celalberq/fpga-orin-renewable-energy-systems/system-integration/reports/assets/demo_final_full.png

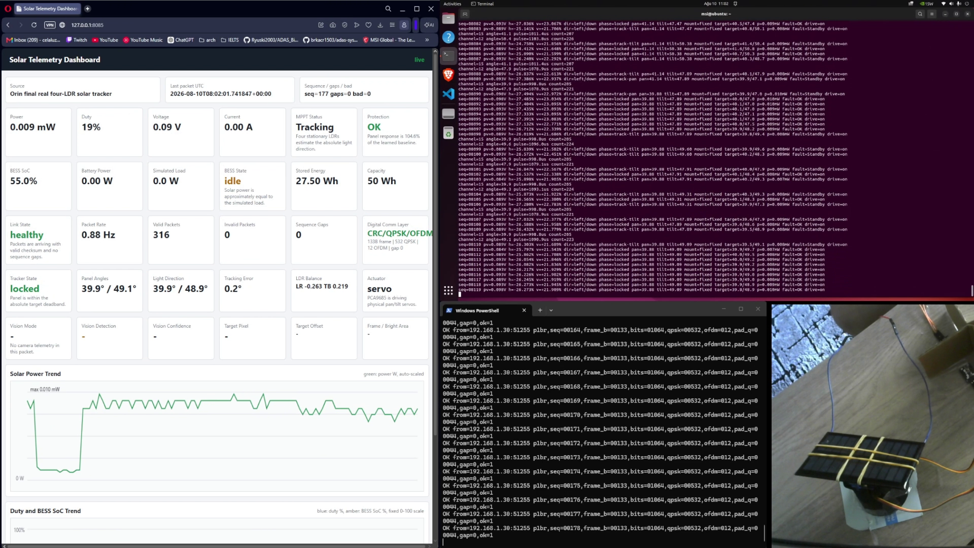
system-integration/reports/assets/demo_final_full.png
