celalberq/fpga-orin-renewable-energy-systems/network-telemetry-dashboard/hardware/README.txt

Network Telemetry Dashboard Hardware Scope
=====================

The validated network layer is PC software over the existing Ethernet/Wi-Fi
LAN. No dedicated inline Ethernet FPGA appliance is claimed.

```text
constraints/  Baseline Nexys Video LED constraint only
pin_maps/     Notes for optional future Ethernet-HDL work
```
