celalberq/fpga-orin-renewable-energy-systems/fpga-digital-communications/data/README.txt

FPGA Digital Communications Communication Evidence Data
==================================

This folder contains simulation outputs, constellation/reference datasets,
live bridge logs, and CRC/QPSK/OFDM profile evidence.

Current generated tracker-link datasets:

```text
tracker_packet_comm_sim.csv
tracker_packet_examples.csv
tracker_qpsk_packet_link_sim.csv
tracker_qpsk_packet_link_constellation.csv
tracker_ofdm_packet_link_sim.csv
tracker_ofdm_resource_grid_example.csv
```

Primary final dataset:

```text
unified_tracker_bess_bidirectional_demo_bridge.csv
  368/368 CRC-valid 161-byte frames, 0 sequence gaps
```
