celalberq/fpga-orin-renewable-energy-systems/network-telemetry-dashboard/data/README.txt

Network Telemetry Dashboard Network and Dashboard Evidence Data
==========================================

This folder contains UDP receiver logs, dashboard logs, reliability-injection
evidence, link-health summaries, and real BESS charge/discharge captures.

Primary final dataset:

```text
unified_tracker_bess_bidirectional_demo_dashboard.csv
  368 valid packets, 0 invalid packets, 0 gaps
  states: idle, charging, discharging
```
