celalberq/fpga-orin-renewable-energy-systems/solar-tracker-bess/data/README.txt

Solar Tracker and BESS Renewable-Control Evidence Data
======================================

This folder contains solar/PWM reference data, LDR calibration and directional
sweeps, fixed-versus-tracking A/B measurements, and transferred Orin tracker
logs.

The final Orin CSV is generated as
`solar-tracker-bess/data/unified_tracker_bess_bidirectional_demo.csv` on the Orin. Matching
PC-side bridge and dashboard records are indexed in `system-integration/demo_evidence`.
