celalberq/fpga-orin-renewable-energy-systems/solar-tracker-bess/docs/README.txt

Solar Tracker and BESS Hardware and Integration Records
=======================================

The numbered records preserve the progression from PWM/UART bring-up through
real MCP3208 sensing, physical two-axis tracking, shading recovery, real BESS
charge/discharge measurement, and the final continuous integrated demo.

Current docs:

```text
board_test_01_pwm_uart.txt
board_test_02_scaled_telemetry.txt
board_test_03_shared_packet_v1.txt
board_test_04_auto_mppt_uart_dashboard.txt
board_test_05_real_sensing_mcp3208.txt
board_test_06_real_solar_voltage_mcp3208.txt
board_test_07_ina226_orin_i2c.txt
board_test_08_orin_ina226_udp_dashboard.txt
board_test_09_pca9685_servo_orin_i2c.txt
board_test_10_pan_tilt_servo_orin_i2c.txt
board_test_11_software_tracker_udp.txt
board_test_12_servo_tracker_udp.txt
board_test_13_mounted_panel_integrated_demo.txt
board_test_14_camera_light_tracker_udp.txt
board_test_15_pan_only_camera_tracker.txt
board_test_16_fixed_vs_pan_tracking_power.txt
board_test_17_ky018_mcp3208_ldr_uart.txt
board_test_18_replacement_pan_tilt_mechanism.txt
board_test_19_ldr_servo_tracker_orin.txt
board_test_20_ldr_tracker_udp_dashboard.txt
board_test_21_ldr_shading_fault_detection.txt
board_test_22_real_bess_ina226_discharge.txt
board_test_23_real_bess_charge_udp_dashboard.txt
board_test_24_unified_tracker_bess_discharge.txt
board_test_25_unified_tracker_bess_bidirectional_demo.txt
servo_mechanics_repair_research_2026_08_07.txt
real_sensing_stage_01_plan.txt
pc_parser_logger_v1.txt
telemetry_format_v1.txt
mppt_fault_logic_v1.txt
```
