celalberq/fpga-orin-renewable-energy-systems/network-telemetry-dashboard/hardware/pin_maps/README.txt

Pin Maps Folder
===============

No dedicated hardware pin map is used by the validated Network Telemetry Dashboard result because
transport and dashboard services run on the PC LAN interfaces. This folder is
reserved for an optional future inline FPGA Ethernet extension.
