celalberq/fpga-orin-renewable-energy-systems/solar-tracker-bess/hardware/pin_maps/README.txt

Pin Maps Folder
===============

Authoritative FPGA assignments are in `../constraints`. The single current
source of truth for bench wiring, connector allocation, power separation, BESS
mode switching, and the BOM is:

```text
system-integration/final_hardware_wiring_2026_08_11.md
```

Dated bring-up details and raw observations remain in `solar-tracker-bess/docs`, especially
board tests 17-25.
