celalberq/fpga-orin-renewable-energy-systems/fpga-digital-communications/hardware/constraints/README.txt

Constraints Folder
==================

Nexys Video XDC files for the validated communication progression are stored
here, from CRC/UART loopback through QPSK and OFDM accounting to the final
tracker-frame batch top.

Primary final board build:

```text
nexys_video_tracker_frame_qpsk_ofdm_batch.xdc
```
