celalberq/fpga-orin-renewable-energy-systems/network-telemetry-dashboard/hardware/constraints/README.txt

Constraints Folder
==================

Current content is the baseline `nexys_video_led_switch.xdc`. Dedicated
Ethernet/UART FPGA constraints are optional future work and are not part of the
validated PC-side UDP dashboard result.
