celalberq/fpga-orin-renewable-energy-systems/solar-tracker-bess/hardware/constraints/README.txt

Constraints Folder
==================

Nexys Video XDC files for PWM/UART, shared packets, MPPT demonstration, real
MCP3208 sensing, and the four-LDR UART build are stored here.

Primary final sensor build:

```text
nexys_video_solar_ldr_uart.xdc
```

The earlier MPPT/PWM constraints remain as validated development-stage assets.
