celalberq/fpga-orin-renewable-energy-systems/solar-tracker-bess/code/sim/README.txt

Simulation Folder
=================

Implemented simulation:

```text
pwm_reference_model.py
```

Additional MPPT, sensing, and protection behavior is validated through the HDL
board tests and live Orin/dashboard records rather than separate files here.
