celalberq/fpga-orin-renewable-energy-systems/fpga-digital-communications/L1_design.txt

L1 Design: Digital Communication Project
========================================

Document status
---------------

```text
ORIGINAL DESIGN TARGET / PLANNING BASELINE

This file preserves the initial project ambition. It is not an as-built
specification and must not be read as a claim that every item below was
implemented. Current delivered scope is documented in `fpga-digital-communications/README.md` and
`system-integration/current_system_status_2026_08_11.txt`.
```

Delivered baseline - 2026-08-11
-------------------------------

```text
Implemented:
  CRC-protected renewable telemetry framing.
  QPSK mapping and AWGN packet-link simulation.
  Software IFFT/FFT OFDM packet-link simulation.
  Nexys Video proofs for CRC, QPSK category mapping, OFDM resource placement,
  pilot/null/padding accounting, and cyclic-prefix sequencing.
  Live PC bridge for compact tracker/panel/BESS frames and QPSK/OFDM sizing.
  Final continuous run: 368/368 software bridge frames valid, zero gaps.

Not implemented:
  Live unified payload passing through the FPGA communication pipeline.
  FPGA IFFT/FFT baseband modem, DAC/ADC or RF link, adaptive modulation,
  hardware receiver BER/EVM measurement, or Orin AI link adaptation.
```

Project title:

FPGA-Accelerated Adaptive OFDM Communication Link with Orin-Based Link Monitoring

Original main goal:

Design and demonstrate a digital communication reliability layer for the shared renewable telemetry packet, where the FPGA handles real-time framing/baseband work and the Orin Nano Super handles experiment control, visualization, logging, and optional AI-based adaptation.

Original target architecture:

```text
Shared solar-tracker-bess renewable telemetry packet
  -> frame builder
  -> CRC/checksum
  -> FPGA transmitter
  -> digital modulation later
  -> OFDM framing
  -> DAC / PWM-DAC / simulated channel / optional RF front-end
  -> ADC / digital loopback
  -> FPGA receiver
  -> link metrics
  -> Orin Nano dashboard and logging
```

Original planned FPGA role:

```text
1. Bit generation or packet input.
2. QPSK and 16-QAM mapping.
3. OFDM frame creation.
4. IFFT/FFT or staged FFT core.
5. Cyclic prefix insertion and removal.
6. Pilot insertion and channel estimation.
7. BER, packet error, and EVM-style metric calculation.
8. Telemetry streaming to Orin.
```

Original planned Orin Nano role:

```text
1. Dashboard for BER, SNR estimate, packet rate, and constellation plots.
2. Experiment control.
3. CSV/JSON logging.
4. Optional AI model that predicts the best modulation mode.
5. Report plots and demo visuals.
```

Original MVP scope:

```text
1. Start with digital loopback inside FPGA.
2. Add noise/channel model in FPGA or Orin simulation.
3. Add ADC/DAC loopback if hardware is available.
4. Add RF front-end only after baseband works.
```

Original success metrics:

```text
1. QPSK link runs end to end.
2. Receiver recovers packets and calculates BER.
3. Orin dashboard displays live metrics.
4. At least two channel conditions are tested.
5. Final demo compares fixed modulation and adaptive modulation.
```

CV value:

This project demonstrates communication theory, reliable telemetry transfer, real-time FPGA signal processing, embedded AI monitoring, and hardware/software co-design.
