celalberq/fpga-orin-renewable-energy-systems/system-integration/demo_evidence/final_system_architecture_2026_08_11.md

# Final Integrated System Architecture

```mermaid
flowchart LR
    LDR["4x KY-018 light sensors"] --> ADC["MCP3208 ADC"]
    PV["Solar panel + 1k load divider"] --> ADC
    ADC --> FPGA["Nexys Video FPGA\nSPI sampling + UART stream"]
    FPGA --> ORIN["Jetson Orin Nano\nLDR tracking + telemetry gateway"]

    ORIN --> PCA["PCA9685"]
    PCA --> PAN["Pan servo CH15"]
    PCA --> TILT["Tilt servo CH12"]
    PAN --> MOUNT["Moving panel mount"]
    TILT --> MOUNT

    CELL["Protected 1S Li-ion cell"] --> INA["INA226 signed BESS sensing"]
    INA --> ORIN
    CELL --> TP["TP4056 charger/protection"]
    TP --> FAN["L9110 fan discharge load"]

    ORIN --> UDP["Unified tracker + panel + BESS UDP packet"]
    UDP --> COMM["FPGA Digital Communications CRC/QPSK/OFDM bridge"]
    COMM --> DASH["Network Telemetry Dashboard live dashboard + CSV logger"]
```

## Ownership

```text
Solar Tracker and BESS: sensing, tracking, servo actuation, panel/BESS telemetry, protection state
FPGA Digital Communications: CRC framing, QPSK/OFDM profile, FPGA communication pipeline proof
Network Telemetry Dashboard: UDP transport, validation, sequence-gap monitoring, dashboard, CSV logs
```

## Final Unified Packet Profile

```text
Payload: 157 bytes
CRC frame: 161 bytes / 1288 bits
QPSK: 644 symbols
OFDM: 14 symbols
QPSK padding: 28 symbols
```

## Continuous Final Demonstration

```text
Dashboard packets: 368/368 valid, 0 invalid, 0 sequence gaps
Bridge frames: 368/368 CRC-valid, 0 sequence gaps
BESS sequence: idle -> charging -> idle -> discharging -> idle
Tracker: 213 locked samples, 0.012-degree best observed error
```

The TP4056 USB input and fan load were used in separate supervised phases; they
were never active simultaneously. The Orin and Nexys Video remained on their
normal external supplies. The initial approximately 0.63 V INA226 bus value was
an open-path reading and is not used as battery-voltage evidence.
