celalberq/fpga-orin-renewable-energy-systems/system-integration/demo_evidence/demo_run_checklist.txt

Demo Run Checklist
==================

Goal
----

Record one clean 60-90 second demo showing the real four-LDR tracker, physical
two-axis panel movement, shading detection, digital communication bridge, and
network dashboard working together.

Before Starting
---------------

```text
1. Orin is powered on.
2. PC and Orin are on the same network.
3. Orin IP is known. Current known Orin IP: 192.168.1.30.
4. PC IP is known. Current known PC IP: 192.168.1.219.
5. Nexys Video board code uses Vivado part: xc7a200tsbg484-1.
6. Nexys Video is powered and visible on Orin as /dev/ttyUSB0.
7. If dashboard is already running, close the old terminal first.
```

Send To Orin
------------

```text
Skip, already installed.
```

PC Terminal 1: Dashboard
------------------------

```powershell
cd "<repository-root>"
python network-telemetry-dashboard/code/pc_app/solar_live_dashboard.py `
  --udp-host 0.0.0.0 --udp-port 5011 `
  --http-host 127.0.0.1 --http-port 8085 `
  --bess-load-w 0 `
  --log network-telemetry-dashboard/data/solar_live_dashboard_final_demo.csv
```

Open:

```text
http://127.0.0.1:8085
```

Expected:

```text
Top right says live.
Source says Orin final real four-LDR solar tracker after packets arrive.
Link State becomes healthy.
Digital Comm Layer becomes CRC/QPSK/OFDM.
Sequence gaps stays 0 during a clean run.
Invalid packets stays 0 during a clean run.
Protection moves through Standby, Learning, OK, Shading, and back to OK.
```

PC Terminal 2: FPGA Digital Communications Bridge
----------------------------

```powershell
cd "<repository-root>"
python fpga-digital-communications/code/pc_app/tracker_udp_comm_bridge.py `
  --bind-host 0.0.0.0 --bind-port 5013 `
  --forward-host 127.0.0.1 --forward-port 5011 `
  --max-packets 180 `
  --log fpga-digital-communications/data/ldr_tracker_bridge_final_demo.csv
```

Expected terminal lines:

```text
OK from=192.168.1.30:xxxxx p1br,seq=00000,frame_b=00133,bits=01064,qpsk=00532,ofdm=012,pad_q=00044,gap=0,ok=1
```

Orin Window: Real LDR Tracker
-----------------------------

```bash
cd /home/msi
python3 solar-tracker-bess/code/orin_app/ldr_servo_tracker.py \
  --port /dev/ttyUSB0 \
  --calibration-in solar-tracker-bess/data/ldr_ab_calibration.json \
  --sensor-mount fixed --control-mode sequential \
  --max-packets 180 --drive-servos \
  --bus 7 --addr 0x40 --pan-channel 15 --tilt-channel 12 \
  --pan-start 90 --tilt-start 90 \
  --pan-min 10 --pan-max 170 --tilt-min 10 --tilt-max 170 \
  --fixed-tilt-gain 120 --fixed-center-deadband 0.015 \
  --fixed-hemisphere-deadband 0.05 --target-deadband-deg 1.0 \
  --min-step 0.5 --max-step 3.0 --stable-samples 2 --invert-tilt \
  --panel-load-ohms 1000 \
  --shading-learn-samples 8 --shading-drop-ratio 0.5 \
  --shading-trigger-samples 3 --shading-recovery-samples 3 \
  --udp-host 192.168.1.219 --udp-port 5013 \
  --source-label "Orin final real four-LDR solar tracker" \
  --log solar-tracker-bess/data/ldr_tracker_final_demo.csv --overwrite-log
```

Expected terminal lines:

```text
seq=... pv=... h=... v=... phase=... pan=... tilt=... fault=... drive=on
```

Expected dashboard changes:

```text
Panel Angles move from 90/90 toward the real LDR target.
Tracker State reaches locked.
Protection learns a baseline, detects panel-only shading, and recovers.
Digital Comm Layer stays CRC/QPSK/OFDM.
Link State stays healthy.
```

Nexys Video Evidence Clip
-------------------------

Use this when recording the FPGA part:

```text
Vivado part:
  xc7a200tsbg484-1

Board test:
  fpga-digital-communications/code/hdl/tracker_frame_qpsk_ofdm_batch_top.v

Constraints:
  fpga-digital-communications/hardware/constraints/nexys_video_tracker_frame_qpsk_ofdm_batch.xdc

Expected UART:
  p1bat,seq=00013,sym=00532,...,data=00532,pad=00044,pilot=00048,null=00144,cp=00192,crc=81,ok=1
```

What To Capture
---------------

```text
1. 10 seconds: physical panel moving from 90/90 toward the light target.
2. 5 seconds: Orin terminal showing real LDR values and drive=on.
3. 5 seconds: PC bridge showing p1br ok=1.
4. 10 seconds: dashboard live/healthy with gaps 0, bad 0, CRC/QPSK/OFDM.
5. After Protection reaches OK, cover only the panel face until Shading appears.
6. Uncover the panel and capture Protection returning to OK.
7. End on the full hardware setup and healthy dashboard.
```

Demo Talking Points
-------------------

```text
This is one system split into three engineering layers.

solar-tracker-bess is the renewable-energy layer:
  tracker state, solar sensing, INA226, Orin edge gateway.

fpga-digital-communications is the communication reliability layer:
  CRC frame, QPSK symbol mapping, OFDM packet sizing, FPGA validation.

network-telemetry-dashboard is the network monitoring layer:
  UDP transport, packet validation, gap detection, live dashboard.
```

If Something Fails
------------------

```text
Dashboard does not update:
  Check that bridge is forwarding to port 5011.
  Check browser is on http://127.0.0.1:8085.

Bridge does not print:
  Check Orin gateway is sending to PC IP and port 5013.
  Check PC firewall if needed.

INA226 reads zero:
  This can be normal indoors with weak light.
  Use a stronger light or sunlight for power plots.

Digital Comm Layer says raw UDP:
  Orin is probably sending directly to dashboard instead of through the bridge.
  Correct path is Orin -> port 5013 bridge -> port 5011 dashboard.
```

Reliability Warning/Recovery Demo
---------------------------------

Use this after the clean demo is working. This keeps the full integrated path,
but inserts the proxy after the fpga-digital-communications bridge.

Fast PC-side startup:

```powershell
cd "<repository-root>"
powershell -ExecutionPolicy Bypass -File system-integration/demo_evidence/start_reliability_demo_pc.ps1
```

Stop PC-side demo:

```powershell
cd "<repository-root>"
powershell -ExecutionPolicy Bypass -File system-integration/demo_evidence/stop_reliability_demo_pc.ps1
```

Dashboard:

```powershell
cd "<repository-root>"
python network-telemetry-dashboard/code/pc_app/solar_live_dashboard.py --udp-host 0.0.0.0 --udp-port 5011 --http-host 127.0.0.1 --http-port 8085 --bess-load-w 0.1 --recovery-window 10 --log network-telemetry-dashboard/data/solar_live_dashboard_reliability_bridge_log.csv
```

Reliability proxy:

```powershell
cd "<repository-root>"
python network-telemetry-dashboard/code/pc_app/solar_reliability_proxy.py --bind-host 0.0.0.0 --bind-port 5012 --forward-host 127.0.0.1 --forward-port 5011 --drop-every 7 --corrupt-every 9 --inject-first 30 --log network-telemetry-dashboard/data/solar_reliability_proxy_bridge_log.csv
```

FPGA Digital Communications bridge:

```powershell
cd "<repository-root>"
python fpga-digital-communications/code/pc_app/tracker_udp_comm_bridge.py --bind-host 0.0.0.0 --bind-port 5013 --forward-host 127.0.0.1 --forward-port 5012 --log fpga-digital-communications/data/tracker_udp_comm_bridge_reliability_log.csv
```

Orin tracker:

```bash
cd /home/msi
python3 solar-tracker-bess/code/orin_app/tracker_softloop_udp_gateway.py --udp-host 192.168.1.219 --udp-port 5013 --lock-error-deg 10 --ina-enable --ina-bus 7 --ina-addr 0x44 --shunt-ohms 0.1
```

Expected sequence:

```text
1. Dashboard starts healthy.
2. Proxy injects drop/corruption during first 30 packets.
3. Dashboard Link State becomes warning.
4. Proxy automatically returns to clean forwarding.
5. Dashboard Link State becomes recovered after 10 clean recent packets.
```
