celalberq/fpga-orin-renewable-energy-systems/network-telemetry-dashboard/docs/README.txt

Network Telemetry Dashboard Network Verification Records
===================================

These records cover UDP transport, dashboard operation, BESS enrichment, link
health, injected reliability faults, bridge status, and recovery behavior.

Current docs:

```text
network_test_01_solar_udp_gateway.txt
network_test_02_live_dashboard.txt
network_test_03_bess_soc_dashboard.txt
network_test_04_link_health_dashboard.txt
network_test_05_orin_ina226_udp_sensor.txt
network_test_06_software_tracker_udp_dashboard.txt
network_test_07_tracker_reliability_proxy.txt
network_test_08_tracker_bridge_dashboard_status.txt
network_test_09_tracker_bridge_reliability_warning_recovery.txt
network_test_10_camera_tracker_dashboard.txt
```

The final dashboard evidence is stored in
`data/unified_tracker_bess_bidirectional_demo_dashboard.csv`: 368/368 valid
packets, zero invalid packets, and zero sequence gaps.
