celalberq/fpga-orin-renewable-energy-systems/system-integration/demo_evidence/final_presentation/_rendered/slide-02.png

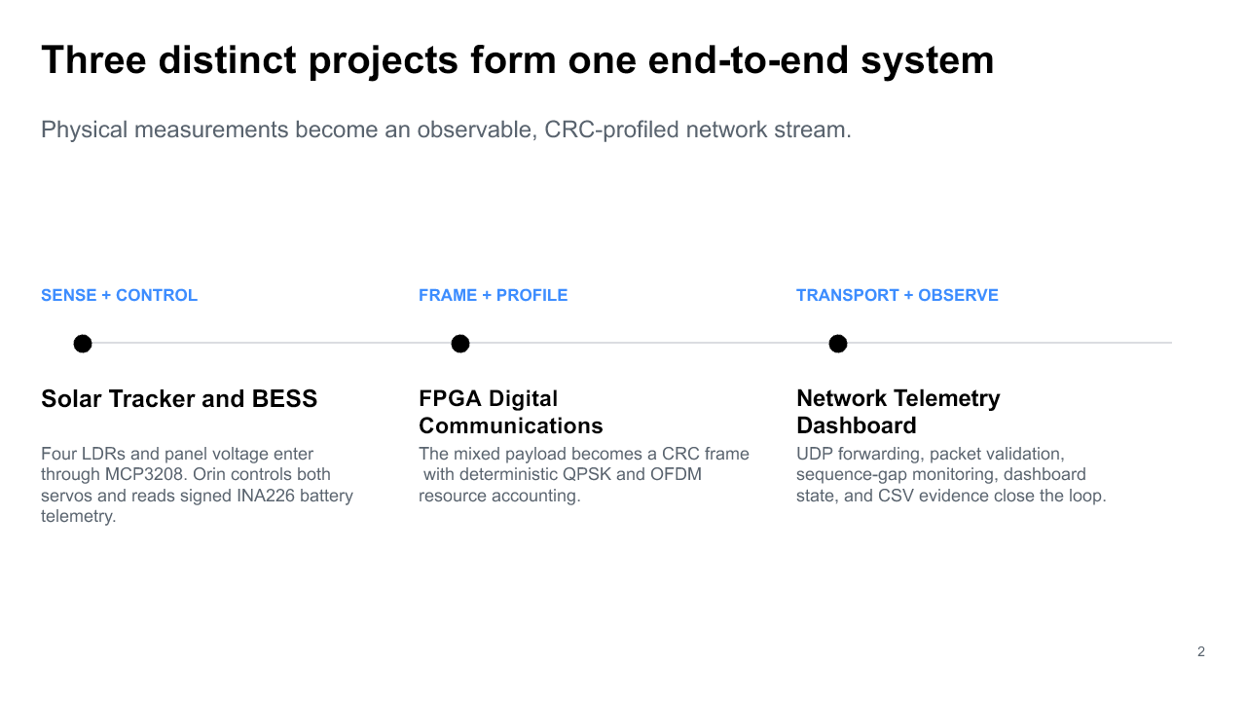
system-integration/demo_evidence/final_presentation/_rendered/slide-02.png
