celalberq/fpga-orin-renewable-energy-systems/system-integration/demo_evidence/final_presentation/_rendered/slide-03.png

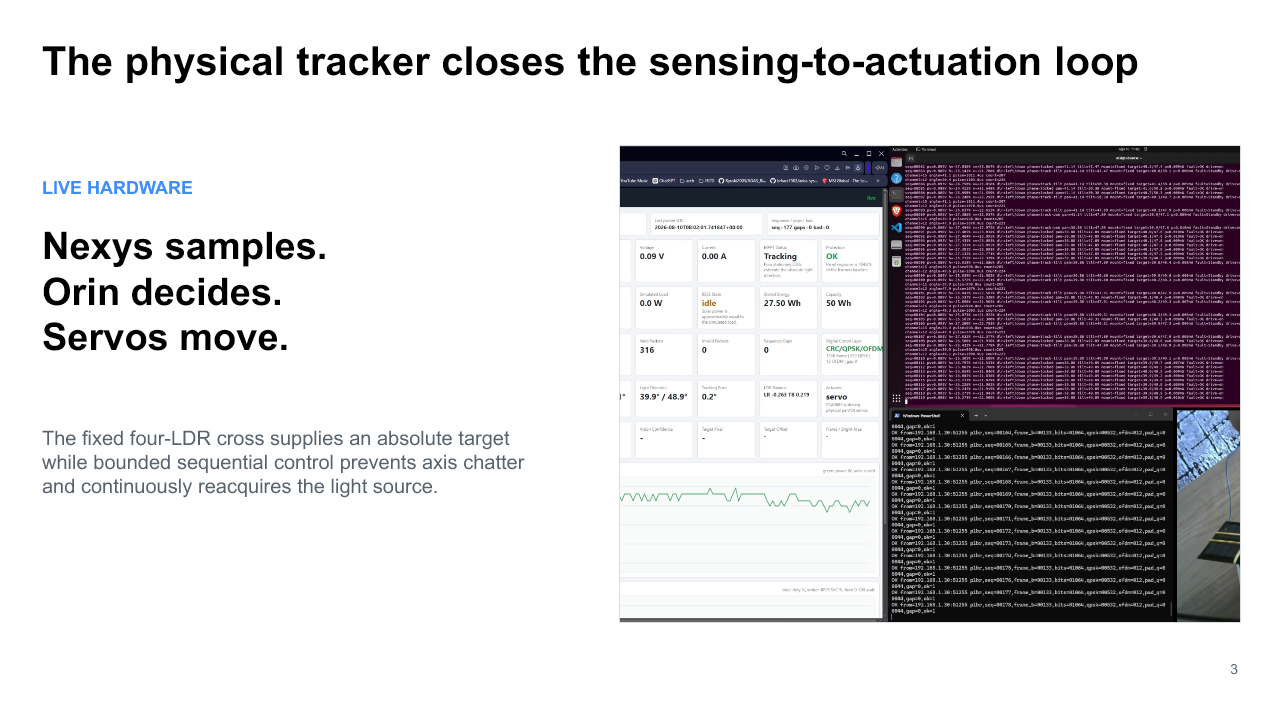
system-integration/demo_evidence/final_presentation/_rendered/slide-03.png
