celalberq/fpga-orin-renewable-energy-systems/system-integration/demo_evidence/image/bess_real_charge_dashboard_2026-08-11.png

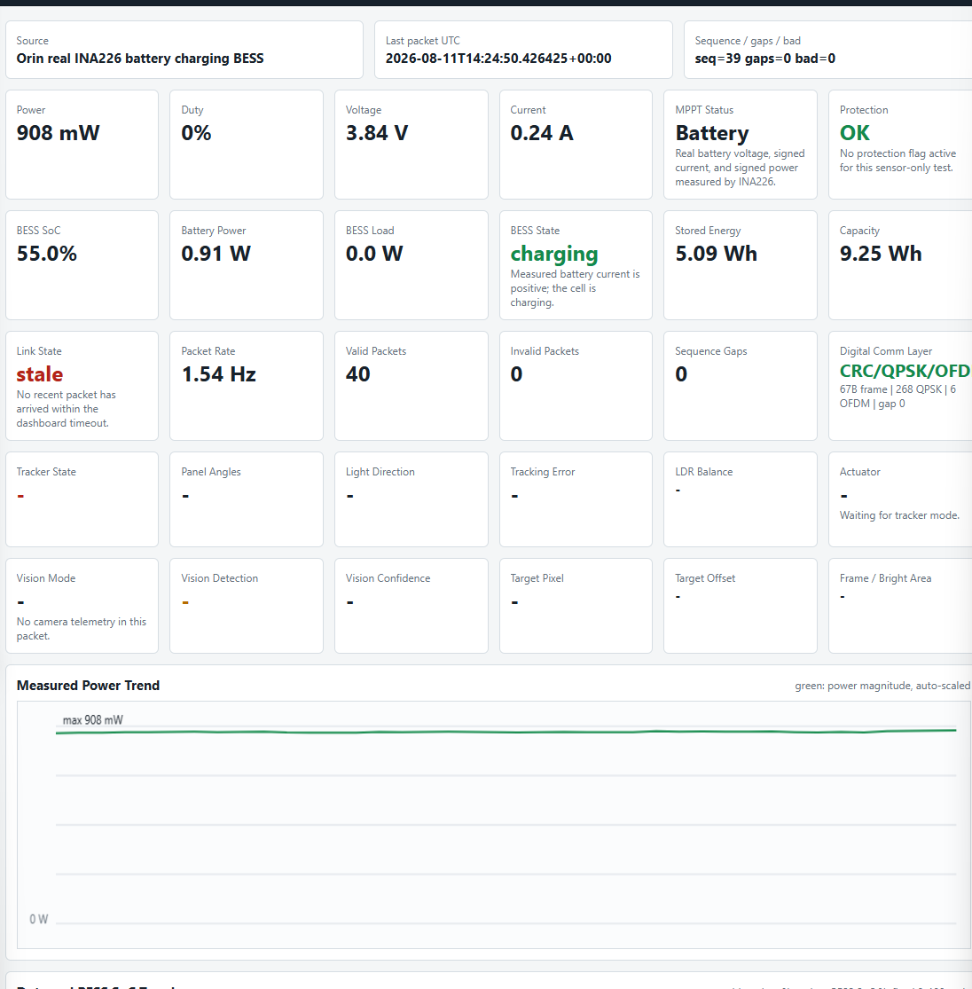
system-integration/demo_evidence/image/bess_real_charge_dashboard_2026-08-11.png
