celalberq/fpga-orin-renewable-energy-systems/system-integration/demo_evidence/image/social-preview.jpg

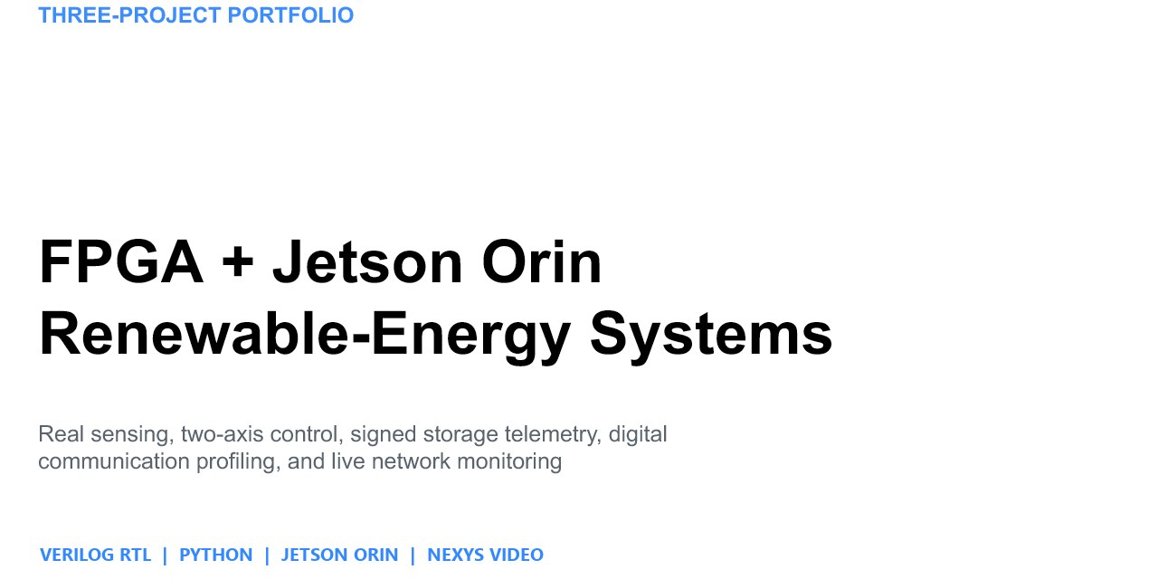
system-integration/demo_evidence/image/social-preview.jpg
