celalberq/fpga-orin-renewable-energy-systems/network-telemetry-dashboard/peripherals_costs_turkey.txt

Peripherals And Turkey Cost Notes: network-telemetry-dashboard Network
=================================================

Price note:

Checked on 2026-06-16. Recheck before buying.

Core peripherals:

```text
1. Managed gigabit switch with port mirroring
   Use: mirror traffic into FPGA for monitor-mode MVP.
   Requirement: port mirroring, gigabit ports, web UI, stable power adapter.
   Turkey cost: check Akakce, Hepsiburada, N11, or local computer stores before buying.
   Expected range: about 800 TL to 2000 TL depending on model.
   Note: this price is not locked because robotics seller pages did not expose a reliable managed-switch listing.

2. CAT5E or CAT6 Ethernet cables
   Use: PC/switch/FPGA/Orin network connections.
   Source page: Robotistan CAT5E 2m cable.
   URL: https://www.robotistan.com/ethernet-kablosu-cat-5e-2-metre
   Note: the product page rendered price as 0 TL during check, so recheck live before buying.

3. Jumper cable set
   Use: UART/SPI debug and control lines if needed.
   Observed price examples:
     40-pin M-M jumper: 55.80 TL
     40-pin F-M jumper: 52.98 TL
   Source: Robotistan
   URL: https://www.robotistan.com/kablo-donusturucu

4. Logic level converter 3.3V-5V
   Use: only if a peripheral is not 3.3V compatible.
   Observed price: 19.16 TL
   Source: Robotistan
   URL: https://www.robotistan.com/voltaj-regulator-karti
```

Still to check before final hardware:

```text
1. Managed switch with port mirroring.
2. Extra CAT5E/CAT6 cables.
3. Optional USB-to-Ethernet adapter for Orin experiments later.
4. Whether the first network demo uses UART metadata, UDP telemetry, or direct Ethernet capture.
```

Budget direction:

```text
Monitor-mode MVP:
  FPGA + Orin + managed switch + cables.

Inline-mode final version:
  FPGA with 2 Ethernet/SFP ports + additional cables + stronger test setup.
```
