celalberq/fpga-orin-renewable-energy-systems/fpga-digital-communications/basic_build_plan.txt

Basic Build Plan: fpga-digital-communications Digital Communication
==============================================

Project:

FPGA-Accelerated Adaptive OFDM Communication Link with PC/Orin Link Monitoring

Goal of this basic build:

Build the digital communication layer around the shared renewable telemetry packet.

We do this:

```text
1. Use the shared solar-tracker-bess telemetry packet as payload.
2. Add digital communication framing.
3. Add CRC-8 for error detection.
4. Simulate bit errors and frame errors.
5. Later add QPSK before OFDM.
6. Use internal FPGA-style loopback as the first board version.
```

Add these:

```text
Design blocks:
  - shared telemetry packet payload
  - frame builder
  - CRC-8 generator
  - controlled channel/error model
  - frame checker
  - QPSK mapper
  - channel/loopback placeholder
  - QPSK demapper
  - packet checker
  - BER/error counter
  - telemetry output

Telemetry fields:
  - project name
  - modulation mode
  - packet count
  - bit count
  - error count
  - BER
  - link status

Folders already prepared:
  - code/hdl
  - code/sim
  - code/pc_app
  - code/tests
  - hardware/constraints
  - hardware/pin_maps
```

This will achieve:

```text
1. A clean first communication prototype that does not depend on RF hardware.
2. A measurable result through BER and packet counters.
3. A strong base for OFDM later.
4. A path where PC scripts can later move to Orin.
5. A portfolio story showing FPGA DSP and communication design.
```

Then code part:

```text
First HDL files:
  - comm_frame_loopback_top.v: BOARD PASS
  - crc8_byte.v: BOARD PASS
  - uart_tx.v: BOARD PASS
  - frame_builder.v: later split-out module
  - error_injector.v: later split-out module
  - frame_checker.v: later split-out module
  - qpsk_mapper.v: BOARD PASS
  - qpsk_demapper.v: BOARD PASS
  - qpsk_loopback_top.v: BOARD PASS
  - qpsk_channel_model_top.v: BOARD PASS
  - ofdm_resource_grid_counter_top.v: BOARD PASS
  - ofdm_cp_grid_sequencer_top.v: READY FOR BOARD
  - bit_source.v
  - packet_checker.v
  - ber_counter.v
  - telemetry_formatter.v
  - top_comm_basic.v

First simulation files:
  - shared_packet_comm_sim.py: DONE
  - qpsk_packet_link_sim.py: DONE
  - ofdm_packet_link_sim.py: DONE
  - qpsk_reference_model.py
  - test_qpsk_mapper.sv
  - test_qpsk_demapper.sv
  - expected_packets.txt

First PC app files:
  - comm_log_reader.py
  - ber_plotter.py
```

Not included in first version:

```text
1. SDR
2. RF transmitter/receiver
3. External ADC/DAC
4. Full OFDM
5. AI adaptive modulation
```

Upgrade path:

```text
Version 1: shared telemetry packet framing + CRC simulation: DONE
Version 2: FPGA frame builder/checker loopback: BOARD PASS
Version 3: QPSK loopback using same packet payload: SIM PASS
Version 4: FPGA QPSK mapper/demapper loopback: BOARD PASS
Version 5: add noise/channel model: BOARD PASS
Version 6: add OFDM framing: SIM PASS
Version 7: first FPGA OFDM resource-grid counter: BOARD PASS
Version 8: FPGA OFDM cyclic-prefix/resource-grid sequencer: READY FOR BOARD
Version 9: add adaptive mode control
Version 10: add external analog/RF hardware if budget allows
```
