celalberq/fpga-orin-renewable-energy-systems/fpga-digital-communications/docs/comm_test_04_tracker_packet_framing.txt

FPGA Digital Communications Communication Test 04: Tracker Packet Framing and CRC
=============================================================

Status
------

```text
PASS
```

Goal
----

Upgrade the digital communication payload from the older compact `p3` solar
packet to the newer Orin tracker/INA226 packet.

This keeps fpga-digital-communications aligned with the current integrated system:

```text
solar-tracker-bess: software tracker + INA226 sensing
network-telemetry-dashboard: UDP dashboard + reliability proxy
fpga-digital-communications: framing, CRC, QPSK, and OFDM protection for that same telemetry
```

Payload profile
---------------

Example:

```text
trk,seq=00023,pan=124.9,tilt=102.6,sun_pan=127.0,sun_tilt=102.8,err=002.1,st=lock,v_mv=05506,i_ma=00421,p_mw=02318,src=ina,act=sw
```

Frame format
------------

```text
preamble:
  0xA5 0x5A

length:
  1 byte payload length

payload:
  ASCII tracker telemetry packet

crc:
  CRC-8 over length + payload
```

Result
------

```text
payload_bytes=129
frame_bytes=133
frame_ok=1
```

Observed simulation:

```text
target_ber frames measured_ber frame_errors crc_detected undetected
0          1000   0.00000000   0            0            0
1e-05      1000   0.00000940   10           10           0
0.0001     1000   0.00009211   94           94           0
0.001      1000   0.00104605   656          651          5
0.01       1000   0.01011372   1000         998          2
```

Files
-----

```text
fpga-digital-communications/code/sim/tracker_packet_profile.py
fpga-digital-communications/code/sim/tracker_packet_comm_sim.py
fpga-digital-communications/data/tracker_packet_comm_sim.csv
fpga-digital-communications/data/tracker_packet_examples.csv
```

Run
---

```text
cd "<repository-root>"
python fpga-digital-communications/code/sim/tracker_packet_comm_sim.py
```

Nexys Video Vivado part
-----------------------

```text
xc7a200tsbg484-1
```
