celalberq/fpga-orin-renewable-energy-systems/network-telemetry-dashboard/docs/network_test_01_solar_udp_gateway.txt

Network Telemetry Dashboard Network Test 01: Solar Telemetry UDP Gateway
===================================================

Status
------

```text
LIVE PASS
```

Goal
----

Move from isolated board tests to an integrated system demo.

This test takes the working solar-tracker-bess solar telemetry packet, validates it on the PC,
wraps it as UDP JSON, and logs it as network-telemetry-dashboard network telemetry.

Why this speeds up the actual project
-------------------------------------

```text
Before:
  solar-tracker-bess solar packet works
  fpga-digital-communications communication tests work
  network-telemetry-dashboard only has a stored frame parser

Now:
  live solar packet -> PC/Orin-style gateway -> UDP network stream -> network log
```

Vivado board code
-----------------

Use the existing solar-tracker-bess solar packet board build.

```text
Board:
  Digilent Nexys Video 410-316

Vivado part code:
  xc7a200tsbg484-1

Top module:
  solar_packet_v1_uart_top

HDL sources:
  solar-tracker-bess/code/hdl/uart_tx.v
  solar-tracker-bess/code/hdl/pwm_generator.v
  solar-tracker-bess/code/hdl/solar_packet_v1_uart_top.v

Constraints:
  solar-tracker-bess/hardware/constraints/nexys_video_solar_packet_v1_uart.xdc
```

Network scripts
---------------

```text
Gateway:
  network-telemetry-dashboard/code/pc_app/solar_telemetry_udp_gateway.py

Receiver:
  network-telemetry-dashboard/code/pc_app/solar_telemetry_udp_receiver.py
```

Run with live Nexys Video telemetry
-----------------------------------

Terminal 1:

```text
cd "<repository-root>"
python network-telemetry-dashboard/code/pc_app/solar_telemetry_udp_receiver.py --bind-host 127.0.0.1 --bind-port 5005
```

Terminal 2:

```text
cd "<repository-root>"
python network-telemetry-dashboard/code/pc_app/solar_telemetry_udp_gateway.py --port COM6 --baud 115200 --udp-host 127.0.0.1 --udp-port 5005
```

Run without the board
---------------------

```text
cd "<repository-root>"
python network-telemetry-dashboard/code/pc_app/solar_telemetry_udp_gateway.py --line "p3,seq=00001,d_pct=00050,v_mv=14560,i_ma=01268,p_mw=18462,mppt=up,f=0,chk=CC,raw=80" --no-send --max-lines 1
```

Expected gateway output
-----------------------

```text
OK udp->127.0.0.1:5005 p3,seq=00001,d_pct=00050,v_mv=14560,i_ma=01268,p_mw=18462,mppt=up,f=0,chk=CC,raw=80
```

Expected receiver output
------------------------

```text
OK from=127.0.0.1:<port> seq=1 p_mw=18462
```

Output logs
-----------

```text
network-telemetry-dashboard/data/solar_udp_gateway_log.csv
network-telemetry-dashboard/data/solar_udp_receiver_log.csv
```

Pass condition
--------------

```text
1. Receiver starts and listens on UDP port 5005.
2. Gateway reads the same p3 packet format already used by solar-tracker-bess.
3. Gateway checksum validation says OK.
4. Receiver prints seq and p_mw.
5. Both CSV logs are created.
```

Observed live result
--------------------

```text
Date:
  2026-07-12

Board:
  Nexys Video running solar-tracker-bess solar_packet_v1_uart_top

Gateway:
  COM6 at 115200 baud
  UDP destination 127.0.0.1:5005

Receiver:
  UDP bind 127.0.0.1:5005

Observed receiver output:
  OK from=127.0.0.1:<port> seq=524 p_mw=6000
  OK from=127.0.0.1:<port> seq=525 p_mw=6000
  OK from=127.0.0.1:<port> seq=526 p_mw=6000

Observed gateway output:
  OK udp->127.0.0.1:5005 p3,seq=00524,d_pct=00000,v_mv=12000,i_ma=00500,p_mw=06000,mppt=hd,f=0,chk=52,raw=00
```

Project meaning
---------------

```text
solar-tracker-bess:
  produces renewable telemetry.

network-telemetry-dashboard:
  transports and logs that telemetry as a network stream.

Future Orin:
  replaces the PC receiver with dashboard, database, and anomaly/fault detection.
```
