celalberq/fpga-orin-renewable-energy-systems/network-telemetry-dashboard/docs/network_test_04_link_health_dashboard.txt

Network Telemetry Dashboard Network Test 04: Telemetry Link Health Dashboard
=======================================================

Status
------

```text
SMOKE PASS / READY FOR LIVE TEST
```

Goal
----

Add communication reliability status to the same solar+BESS dashboard.

This connects the fpga-digital-communications digital communication story to the integrated
renewable/network dashboard.

Data path
---------

```text
Nexys Video p3 packet
  -> checksum validation in UDP gateway
  -> sequence/gap tracking in dashboard
  -> link health panel
```

Run dashboard
-------------

```text
cd "<repository-root>"
python network-telemetry-dashboard/code/pc_app/solar_live_dashboard.py --udp-host 127.0.0.1 --udp-port 5010 --http-host 127.0.0.1 --http-port 8084 --bess-capacity-wh 50 --bess-initial-soc 55 --bess-load-w 10
```

Open:

```text
http://127.0.0.1:8084
```

Run gateway
-----------

```text
cd "<repository-root>"
python network-telemetry-dashboard/code/pc_app/solar_telemetry_udp_gateway.py --port COM6 --baud 115200 --udp-host 127.0.0.1 --udp-port 5010
```

Dashboard additions
-------------------

```text
Link State:
  healthy / warning / stale / waiting

Packet Rate:
  estimated received packet rate in Hz

Valid Packets:
  packets passing checksum and sequence validation

Invalid Packets:
  packets failing validation

Sequence Gaps:
  detected missing packet count
```

Smoke-test result
-----------------

```text
Input packet:
  p3,seq=00236,d_pct=00025,v_mv=12280,i_ma=00656,p_mw=08055,mppt=up,f=0,chk=99,raw=40

Dashboard API:
  link.state=healthy
  packet_rate_hz present
  valid_packets=1
  invalid_packets=0
  sequence_gaps=0
```

Why this matters
----------------

```text
The dashboard now shows:
  renewable telemetry
  MPPT state
  protection state
  BESS state of charge
  network transport
  communication/link reliability
```
