celalberq/fpga-orin-renewable-energy-systems/network-telemetry-dashboard/data/solar_bess_dashboard_test_log.csv

received_utc | valid | error | seq_gap | seq | d_pct | v_mv | i_ma | p_mw | mppt | fault | chk | computed_chk | bess_soc_pct | bess_power_w | bess_load_w | bess_state | bess_energy_wh | bess_capacity_wh | raw_line
2026-07-13T13:25:49.695426+00:00 | 1 |  |  | 236 | 25 | 12280 | 656 | 8055 | up | 0 | 99 | 99 | 55.0 | -1.945 | 10.0 | discharging | 27.5 | 50.0 | p3,seq=00236,d_pct=00025,v_mv=12280,i_ma=00656,p_mw=08055,mppt=up,f=0,chk=99,raw=40
