celalberq/fpga-orin-renewable-energy-systems/solar-tracker-bess/hardware/constraints/nexys_video_solar_ldr_uart.xdc

## Nexys Video constraints for the panel plus four-KY-018 test.
## Top module: solar_ldr_uart_top
## Vivado part code: xc7a200tsbg484-1
##
## MCP3208 on Pmod JB:
##   JB1 adc_cs_n, JB2 adc_mosi, JB3 adc_miso, JB4 adc_sclk
## Power the MCP3208 and KY-018 modules from Pmod 3.3V and GND.
## Never drive an FPGA, Pmod, or MCP3208 input above 3.3V.

set_property -dict { PACKAGE_PIN R4 IOSTANDARD LVCMOS33 } [get_ports { clk }]
create_clock -add -name sys_clk_pin -period 10.00 -waveform {0 5} [get_ports clk]

set_property -dict { PACKAGE_PIN E22 IOSTANDARD LVCMOS12 } [get_ports { sw[0] }]
set_property -dict { PACKAGE_PIN F21 IOSTANDARD LVCMOS12 } [get_ports { sw[1] }]
set_property -dict { PACKAGE_PIN G21 IOSTANDARD LVCMOS12 } [get_ports { sw[2] }]
set_property -dict { PACKAGE_PIN G22 IOSTANDARD LVCMOS12 } [get_ports { sw[3] }]
set_property -dict { PACKAGE_PIN H17 IOSTANDARD LVCMOS12 } [get_ports { sw[4] }]
set_property -dict { PACKAGE_PIN J16 IOSTANDARD LVCMOS12 } [get_ports { sw[5] }]
set_property -dict { PACKAGE_PIN K13 IOSTANDARD LVCMOS12 } [get_ports { sw[6] }]
set_property -dict { PACKAGE_PIN M17 IOSTANDARD LVCMOS12 } [get_ports { sw[7] }]

set_property -dict { PACKAGE_PIN T14 IOSTANDARD LVCMOS25 } [get_ports { led[0] }]
set_property -dict { PACKAGE_PIN T15 IOSTANDARD LVCMOS25 } [get_ports { led[1] }]
set_property -dict { PACKAGE_PIN T16 IOSTANDARD LVCMOS25 } [get_ports { led[2] }]
set_property -dict { PACKAGE_PIN U16 IOSTANDARD LVCMOS25 } [get_ports { led[3] }]
set_property -dict { PACKAGE_PIN V15 IOSTANDARD LVCMOS25 } [get_ports { led[4] }]
set_property -dict { PACKAGE_PIN W16 IOSTANDARD LVCMOS25 } [get_ports { led[5] }]
set_property -dict { PACKAGE_PIN W15 IOSTANDARD LVCMOS25 } [get_ports { led[6] }]
set_property -dict { PACKAGE_PIN Y13 IOSTANDARD LVCMOS25 } [get_ports { led[7] }]

set_property -dict { PACKAGE_PIN AA19 IOSTANDARD LVCMOS33 } [get_ports { uart_rx_out }]
set_property -dict { PACKAGE_PIN V18 IOSTANDARD LVCMOS33 } [get_ports { uart_tx_in }]

set_property -dict { PACKAGE_PIN V9 IOSTANDARD LVCMOS33 } [get_ports { adc_cs_n }]
set_property -dict { PACKAGE_PIN V8 IOSTANDARD LVCMOS33 } [get_ports { adc_mosi }]
set_property -dict { PACKAGE_PIN V7 IOSTANDARD LVCMOS33 } [get_ports { adc_miso }]
set_property -dict { PACKAGE_PIN W7 IOSTANDARD LVCMOS33 } [get_ports { adc_sclk }]
