celalberq/fpga-orin-renewable-energy-systems/(commit log)

2026-08-11 Initial release: FPGA-Orin solar tracker and BESS platform
    [bess_ina226_charge_udp_comm_bridge.csv, bess_ina226_udp_comm_bridge.csv, bess_ina226_udp_comm_bridge_valid.csv, bess_real_charge_dashboard.csv, bess_real_discharge_dashboard.csv, bess_real_discharge_dashboard_valid.csv, bringup_uart_log.csv, camera_light_tracker_udp_synthetic_smoke.csv]
2026-08-11 Clarify three-project repository structure
    [bess_ina226_charge_udp_comm_bridge.csv, bess_ina226_udp_comm_bridge.csv, bess_ina226_udp_comm_bridge_valid.csv, bess_real_charge_dashboard.csv, bess_real_discharge_dashboard.csv, bess_real_discharge_dashboard_valid.csv, camera_light_tracker_udp_synthetic_smoke.csv, ldr_center_calibration_2026_08_08.csv]
